evilcomputer12/Fizika-2/FizikaProekt/ProgramaZaAkvizicija/FEITIRTempus/feit.jpg

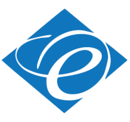
FizikaProekt/ProgramaZaAkvizicija/FEITIRTempus/feit.jpg
