evilcomputer12/Fizika-2/FizikaProekt/ProgramaZaAkvizicija/FEITIRTempus/ukim.jpg

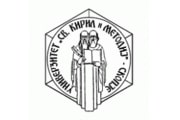
FizikaProekt/ProgramaZaAkvizicija/FEITIRTempus/ukim.jpg
