evilcomputer12/Fizika-2/FizikaProekt/PCB/PlockaFinal.pcb.pdf

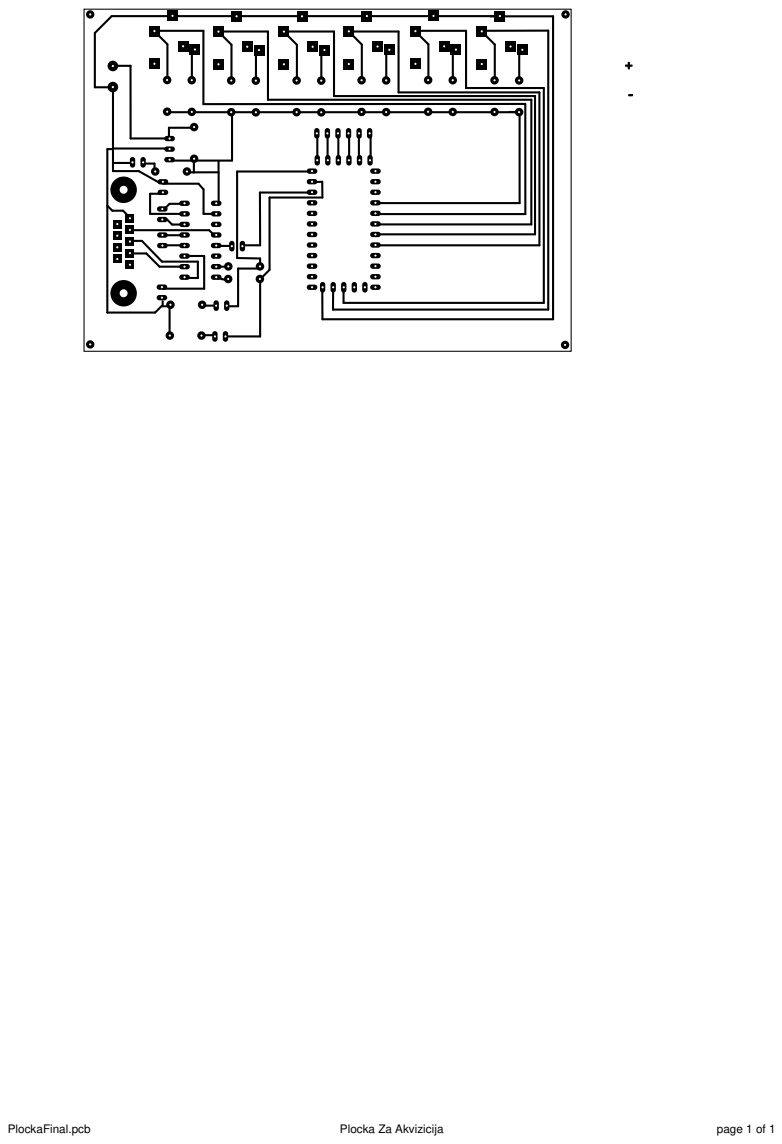
[picture p10: page 1]
PlockaFinal.pcb; Plocka Za Akvizicija; page 1 of 1
