evilcomputer12/Fizika-2/FizikaProekt/PCB/PCB Wizard - Professional Edition - PlockaFinal.pdf

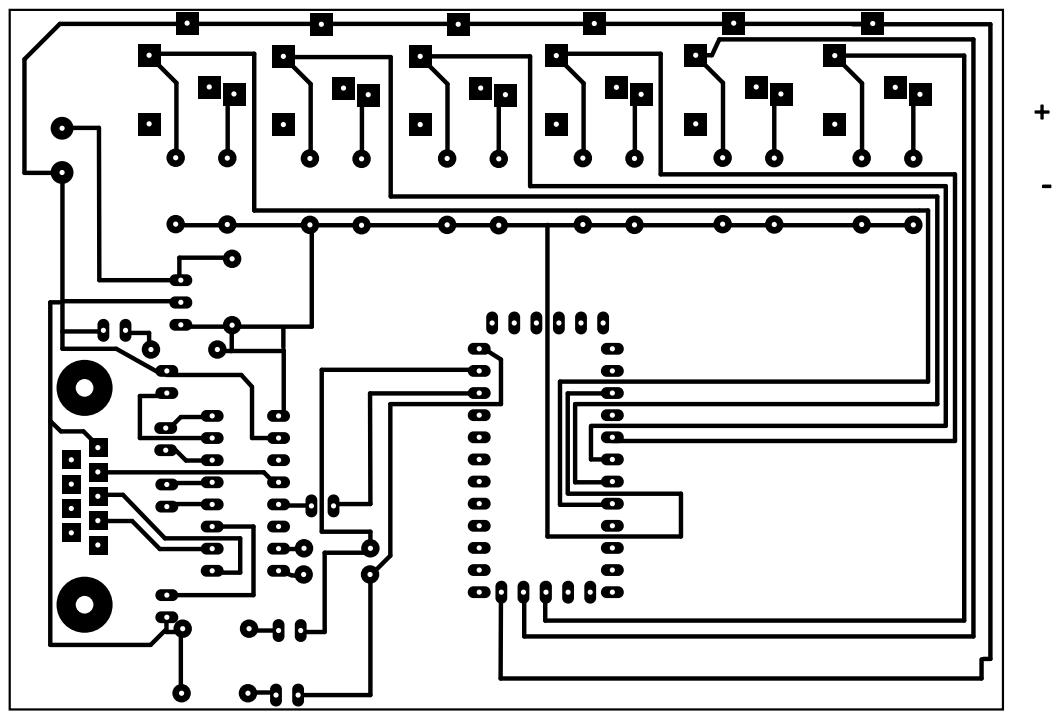
[picture p11: page 1]
