evilcomputer12/Fizika-2/FizikaProekt/PCB/plocki1.pdf

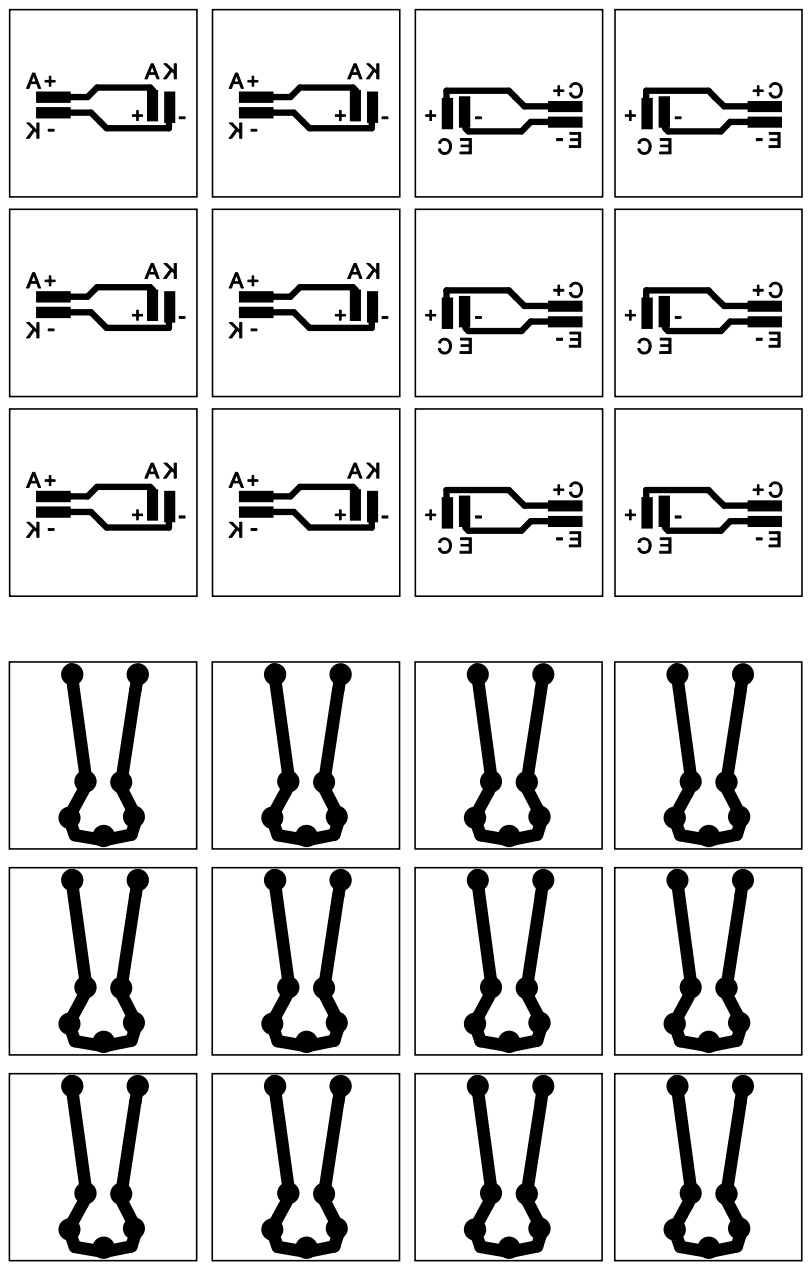
[picture p12: page 1]
