evilcomputer12/Fizika-2/(list of files, drawings)

Other design files:
FizikaProekt/KoristenSoftver/PCB Wizard 3.50 Pro Unlimited/Books/PCB Wizard Help/555 Timer.pcb
FizikaProekt/KoristenSoftver/PCB Wizard 3.50 Pro Unlimited/Books/PCB Wizard Help/Anchor.pcb
FizikaProekt/KoristenSoftver/PCB Wizard 3.50 Pro Unlimited/Books/PCB Wizard Help/Arrange.pcb
FizikaProekt/KoristenSoftver/PCB Wizard 3.50 Pro Unlimited/Books/PCB Wizard Help/Author.pcb
FizikaProekt/KoristenSoftver/PCB Wizard 3.50 Pro Unlimited/Books/PCB Wizard Help/Background.pcb
FizikaProekt/KoristenSoftver/PCB Wizard 3.50 Pro Unlimited/Books/PCB Wizard Help/Board.pcb
FizikaProekt/KoristenSoftver/PCB Wizard 3.50 Pro Unlimited/Books/PCB Wizard Help/Books.pcb
FizikaProekt/KoristenSoftver/PCB Wizard 3.50 Pro Unlimited/Books/PCB Wizard Help/Changes.pcb
FizikaProekt/KoristenSoftver/PCB Wizard 3.50 Pro Unlimited/Books/PCB Wizard Help/Circuit.pcb
FizikaProekt/KoristenSoftver/PCB Wizard 3.50 Pro Unlimited/Books/PCB Wizard Help/ClipArt.pcb
FizikaProekt/KoristenSoftver/PCB Wizard 3.50 Pro Unlimited/Books/PCB Wizard Help/Clipboard.pcb
FizikaProekt/KoristenSoftver/PCB Wizard 3.50 Pro Unlimited/Books/PCB Wizard Help/Components.pcb
FizikaProekt/KoristenSoftver/PCB Wizard 3.50 Pro Unlimited/Books/PCB Wizard Help/Convert1.pcb
FizikaProekt/KoristenSoftver/PCB Wizard 3.50 Pro Unlimited/Books/PCB Wizard Help/Convert2.pcb
FizikaProekt/KoristenSoftver/PCB Wizard 3.50 Pro Unlimited/Books/PCB Wizard Help/Convert3.pcb
FizikaProekt/KoristenSoftver/PCB Wizard 3.50 Pro Unlimited/Books/PCB Wizard Help/Convert4.pcb
FizikaProekt/KoristenSoftver/PCB Wizard 3.50 Pro Unlimited/Books/PCB Wizard Help/Convert5.pcb
FizikaProekt/KoristenSoftver/PCB Wizard 3.50 Pro Unlimited/Books/PCB Wizard Help/Convert6.pcb
FizikaProekt/KoristenSoftver/PCB Wizard 3.50 Pro Unlimited/Books/PCB Wizard Help/Convert7.pcb
FizikaProekt/KoristenSoftver/PCB Wizard 3.50 Pro Unlimited/Books/PCB Wizard Help/Convert.pcb
FizikaProekt/KoristenSoftver/PCB Wizard 3.50 Pro Unlimited/Books/PCB Wizard Help/Copper.pcb
FizikaProekt/KoristenSoftver/PCB Wizard 3.50 Pro Unlimited/Books/PCB Wizard Help/CopperLabel.pcb
FizikaProekt/KoristenSoftver/PCB Wizard 3.50 Pro Unlimited/Books/PCB Wizard Help/CrocClip.pcb
FizikaProekt/KoristenSoftver/PCB Wizard 3.50 Pro Unlimited/Books/PCB Wizard Help/Customize.pcb
FizikaProekt/KoristenSoftver/PCB Wizard 3.50 Pro Unlimited/Books/PCB Wizard Help/Database.pcb
FizikaProekt/KoristenSoftver/PCB Wizard 3.50 Pro Unlimited/Books/PCB Wizard Help/Delete.pcb
FizikaProekt/KoristenSoftver/PCB Wizard 3.50 Pro Unlimited/Books/PCB Wizard Help/Display.pcb
FizikaProekt/KoristenSoftver/PCB Wizard 3.50 Pro Unlimited/Books/PCB Wizard Help/Document.pcb
FizikaProekt/KoristenSoftver/PCB Wizard 3.50 Pro Unlimited/Books/PCB Wizard Help/Drill.pcb
FizikaProekt/KoristenSoftver/PCB Wizard 3.50 Pro Unlimited/Books/PCB Wizard Help/Edit.pcb
FizikaProekt/KoristenSoftver/PCB Wizard 3.50 Pro Unlimited/Books/PCB Wizard Help/Export.pcb
FizikaProekt/KoristenSoftver/PCB Wizard 3.50 Pro Unlimited/Books/PCB Wizard Help/FAQ.pcb
FizikaProekt/KoristenSoftver/PCB Wizard 3.50 Pro Unlimited/Books/PCB Wizard Help/FlyingWire.pcb
FizikaProekt/KoristenSoftver/PCB Wizard 3.50 Pro Unlimited/Books/PCB Wizard Help/Gallery.pcb
FizikaProekt/KoristenSoftver/PCB Wizard 3.50 Pro Unlimited/Books/PCB Wizard Help/GeneralOptions.pcb
FizikaProekt/KoristenSoftver/PCB Wizard 3.50 Pro Unlimited/Books/PCB Wizard Help/Gerber.pcb
FizikaProekt/KoristenSoftver/PCB Wizard 3.50 Pro Unlimited/Books/PCB Wizard Help/Grid.pcb
FizikaProekt/KoristenSoftver/PCB Wizard 3.50 Pro Unlimited/Books/PCB Wizard Help/HeadFoot.pcb
FizikaProekt/KoristenSoftver/PCB Wizard 3.50 Pro Unlimited/Books/PCB Wizard Help/Hyperlink.pcb
FizikaProekt/KoristenSoftver/PCB Wizard 3.50 Pro Unlimited/Books/PCB Wizard Help/Import.pcb
FizikaProekt/KoristenSoftver/PCB Wizard 3.50 Pro Unlimited/Books/PCB Wizard Help/Index.pcb
FizikaProekt/KoristenSoftver/PCB Wizard 3.50 Pro Unlimited/Books/PCB Wizard Help/Item.pcb
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
